pazambranosauc/esp32-devboard/docs/images/schematic-rev-a.png

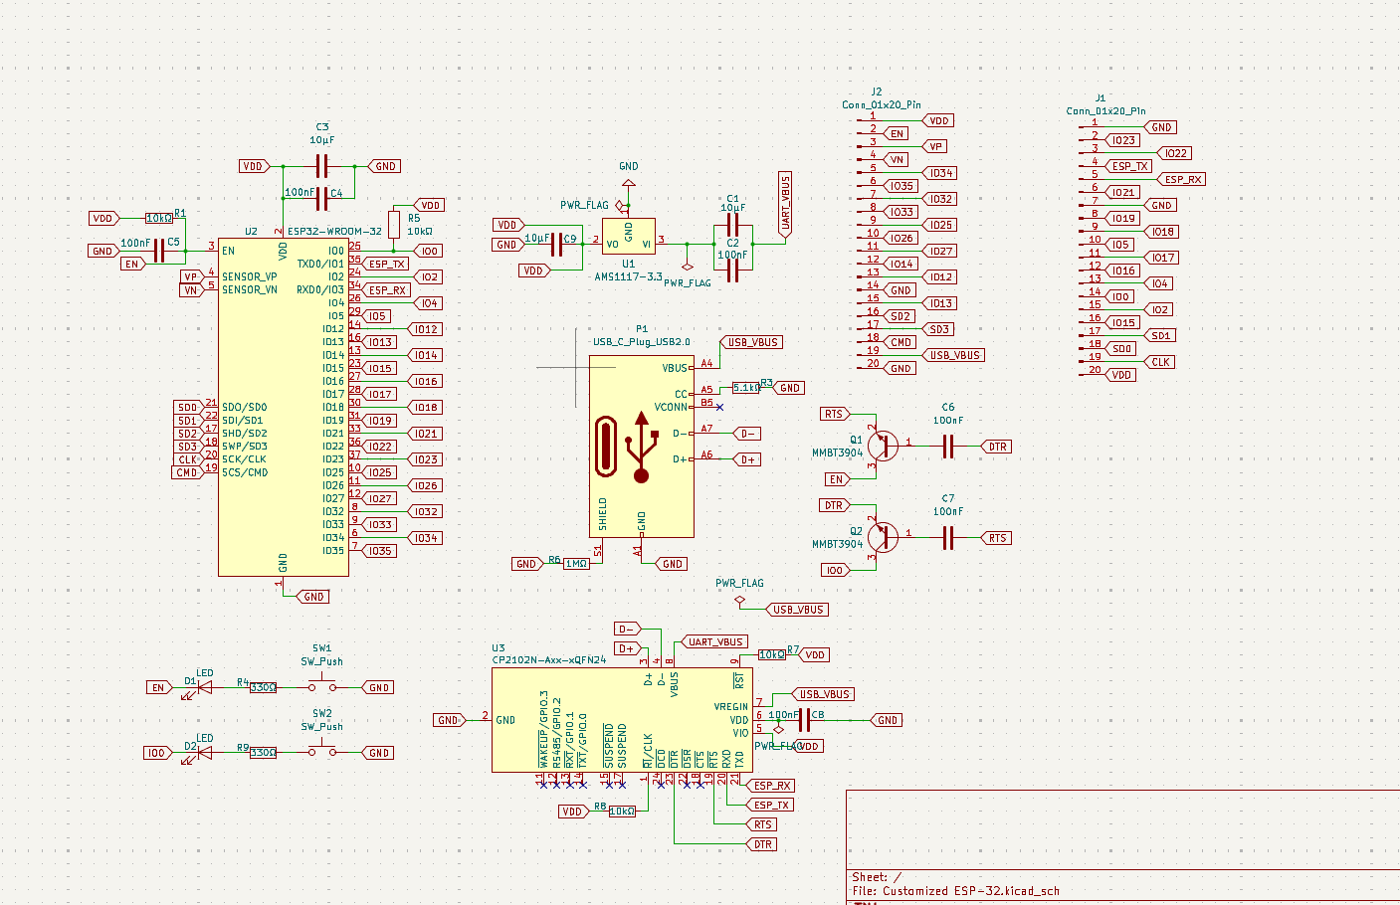
docs/images/schematic-rev-a.png
