pazambranosauc/esp32-devboard/hardware/Customized ESP-32.kicad_pcb

## KiCad design hardware/Customized ESP-32.kicad_pcb (2026-10-17)

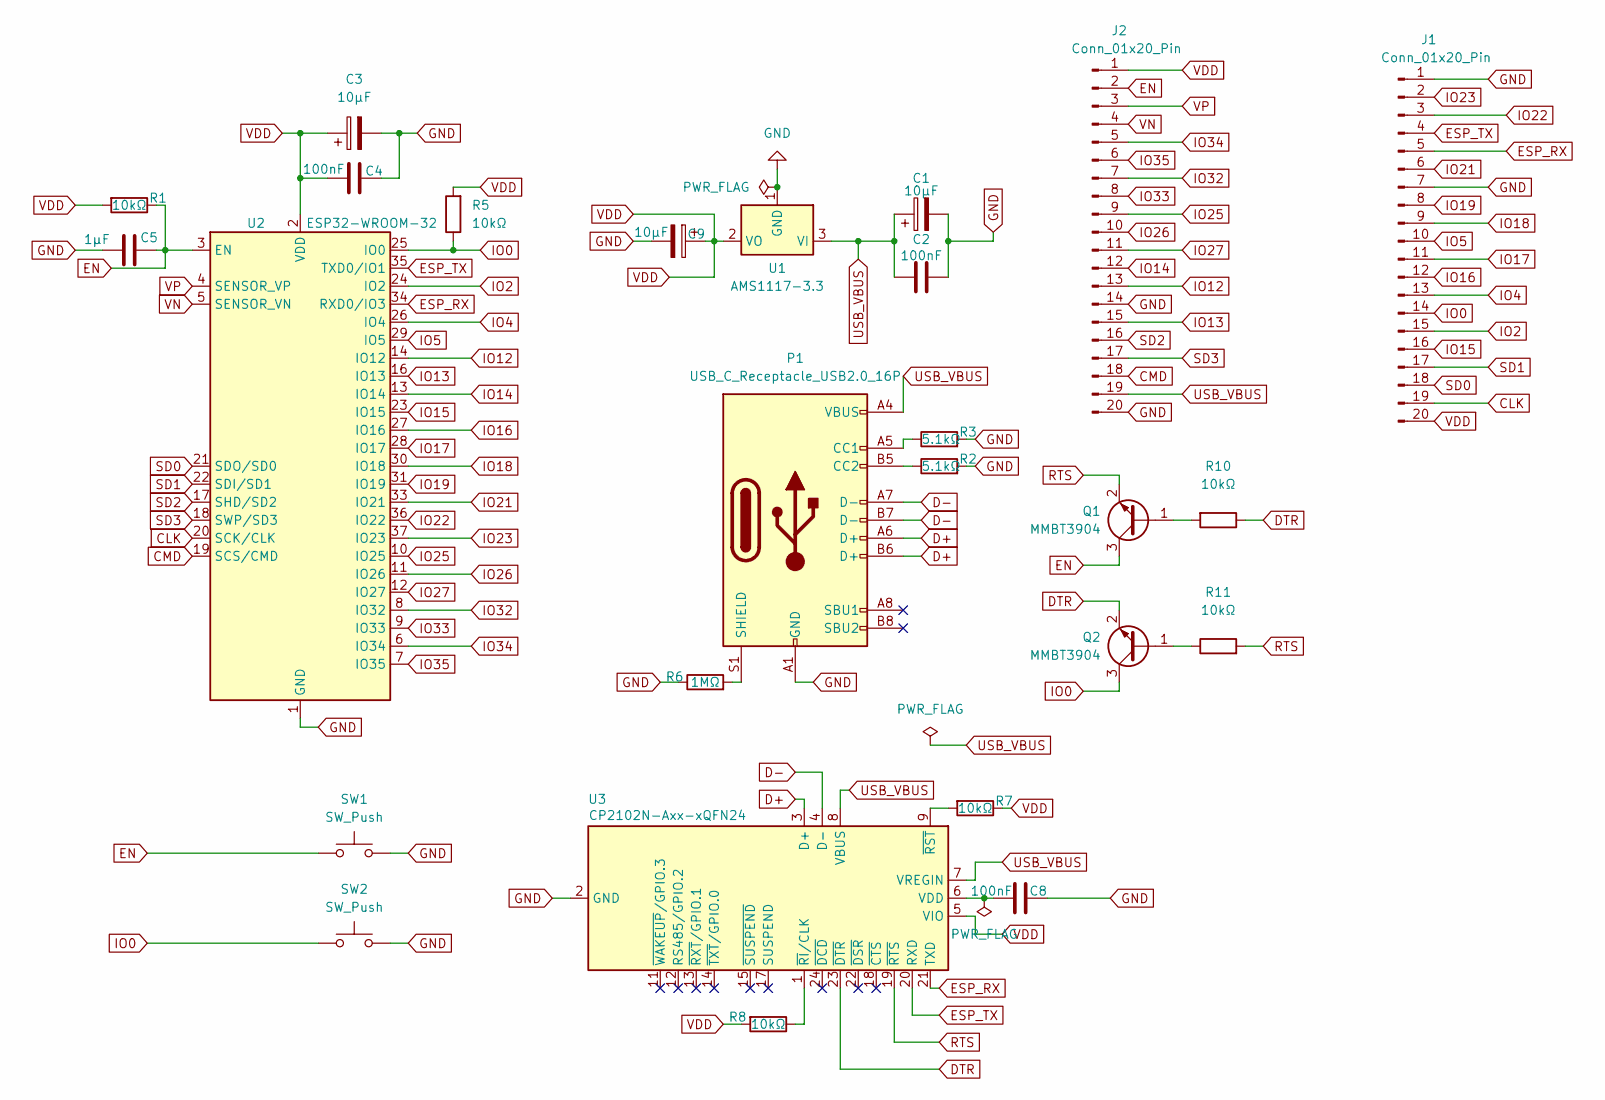
[picture p7: schematic Customized ESP-32.kicad_sch, Custom ESP32 Development Board]

Parts:
C1, C9: 10μF; CP_EIA-3216-18_Kemet-A_HandSolder
C2, C4, C8: 100nF; C_0603_1608Metric_Pad1.08x0.95mm_HandSolder
C3: 10µF; CP_EIA-3216-18_Kemet-A_HandSolder
C5: 1µF; C_0603_1608Metric_Pad1.08x0.95mm_HandSolder
J1, J2: Conn_01x20_Pin; PinHeader_1x20_P2.54mm_Vertical
P1: USB_C_Receptacle_USB2.0_16P; USB_C_Receptacle_GCT_USB4105-xx-A_16P_TopMnt_Horizontal
Q1, Q2: MMBT3904; SOT-23
R1, R5, R7, R8, R10, R11: 10kΩ; R_0603_1608Metric_Pad0.98x0.95mm_HandSolder
R2, R3: 5.1kΩ; R_0603_1608Metric_Pad0.98x0.95mm_HandSolder
R6: 1MΩ; R_0603_1608Metric_Pad0.98x0.95mm_HandSolder
SW1, SW2: SW_Push; SW_Push_SPST_NO_Alps_SKRK
U1: AMS1117-3.3; SOT-223-3_TabPin2
U2: ESP32-WROOM-32
U3: CP2102N-Axx-xQFN24; QFN-24-1EP_4x4mm_P0.5mm_EP2.6x2.6mm

Connections:
CLK: J1.19, U2.20 (SCK/CLK)
CMD: J2.18, U2.19 (SCS/CMD)
D+: P1.A6 (D+), P1.B6 (D+), U3.3 (D+)
D-: P1.A7 (D-), P1.B7 (D-), U3.4 (D-)
DTR: Q2.2 (E), R10.1, U3.23 (~DTR)
EN: C5.2, J2.2, Q1.3 (C), R1.1, SW1.1, U2.3 (EN)
ESP_RX: J1.5, U2.34 (RXD0/IO3), U3.21 (TXD)
ESP_TX: J1.4, U2.35 (TXD0/IO1), U3.20 (RXD)
GND: C1.2, C2.2, C3.2, C4.2, C5.1, C8.1, C9.2, J1.1, J1.7, J2.14, J2.20, P1.A1 (GND), P1.A12 (GND), P1.B1 (GND), P1.B12 (GND), R2.2, R3.2, R6.1, SW1.2, SW2.2, U1.1 (GND), U2.1 (GND), U2.15 (GND), U2.38 (GND), U2.39 (GND), U3.2 (GND), U3.25 (GND)
IO0: J1.14, Q2.3 (C), R5.1, SW2.1, U2.25 (IO0)
IO2: J1.15, U2.24 (IO2)
IO4: J1.13, U2.26 (IO4)
IO5: J1.10, U2.29 (IO5)
IO12: J2.13, U2.14 (IO12)
IO13: J2.15, U2.16 (IO13)
IO14: J2.12, U2.13 (IO14)
IO15: J1.16, U2.23 (IO15)
IO16: J1.12, U2.27 (IO16)
IO17: J1.11, U2.28 (IO17)
IO18: J1.9, U2.30 (IO18)
IO19: J1.8, U2.31 (IO19)
IO21: J1.6, U2.33 (IO21)
IO22: J1.3, U2.36 (IO22)
IO23: J1.2, U2.37 (IO23)
IO25: J2.9, U2.10 (IO25)
IO26: J2.10, U2.11 (IO26)
IO27: J2.11, U2.12 (IO27)
IO32: J2.7, U2.8 (IO32)
IO33: J2.8, U2.9 (IO33)
IO34: J2.5, U2.6 (IO34)
IO35: J2.6, U2.7 (IO35)
unnamed: P1.A5 (CC1), R3.1
unnamed: P1.B5 (CC2), R2.1
unnamed: P1.S1 (SHIELD), R6.2
unnamed: Q1.1 (B), R10.2
unnamed: Q2.1 (B), R11.1
unnamed: C8.2, U3.6 (VDD)
unnamed: R8.1, U3.1 (~RI/CLK)
unnamed: R7.2, U3.9 (~RST)
RTS: Q1.2 (E), R11.2, U3.19 (~RTS)
SD0: J1.18, U2.21 (SDO/SD0)
SD1: J1.17, U2.22 (SDI/SD1)
SD2: J2.16, U2.17 (SHD/SD2)
SD3: J2.17, U2.18 (SWP/SD3)
USB_VBUS: C1.1, C2.1, J2.19, P1.A4 (VBUS), P1.A9 (VBUS), P1.B4 (VBUS), P1.B9 (VBUS), U1.3 (VI), U3.7 (VREGIN), U3.8 (VBUS)
VDD: C3.1, C4.1, C9.1, J1.20, J2.1, R1.2, R5.2, R7.1, R8.2, U1.2 (VO), U2.2 (VDD), U3.5 (VIO)
VN: J2.4, U2.5 (SENSOR_VN)
VP: J2.3, U2.4 (SENSOR_VP)

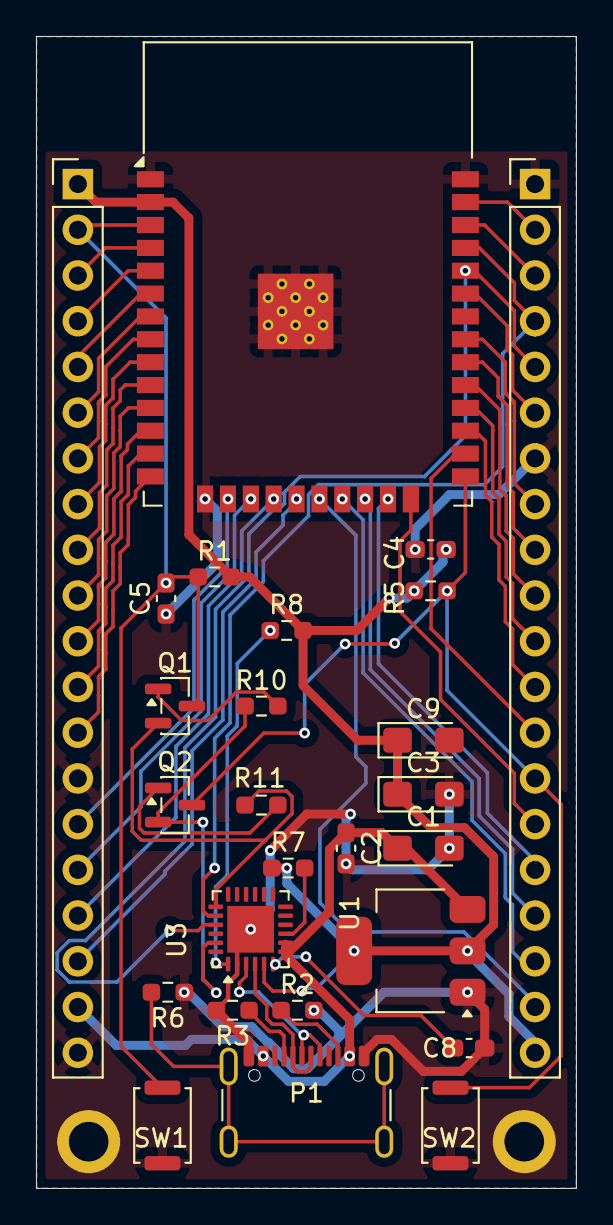
[picture p8: board Customized ESP-32.kicad_pcb from above]

Board: 2 copper layers, 30.0 x 64.0 mm, 26 parts (0 on the bottom side), 48 nets.
